kien242/Reflow-Controller/pcb/Reflow-Controller-Kicad/Reflow-Controller-Kicad.kicad_pcb

## KiCad design pcb/Reflow-Controller-Kicad/Reflow-Controller-Kicad.kicad_pcb (2023-04-20)

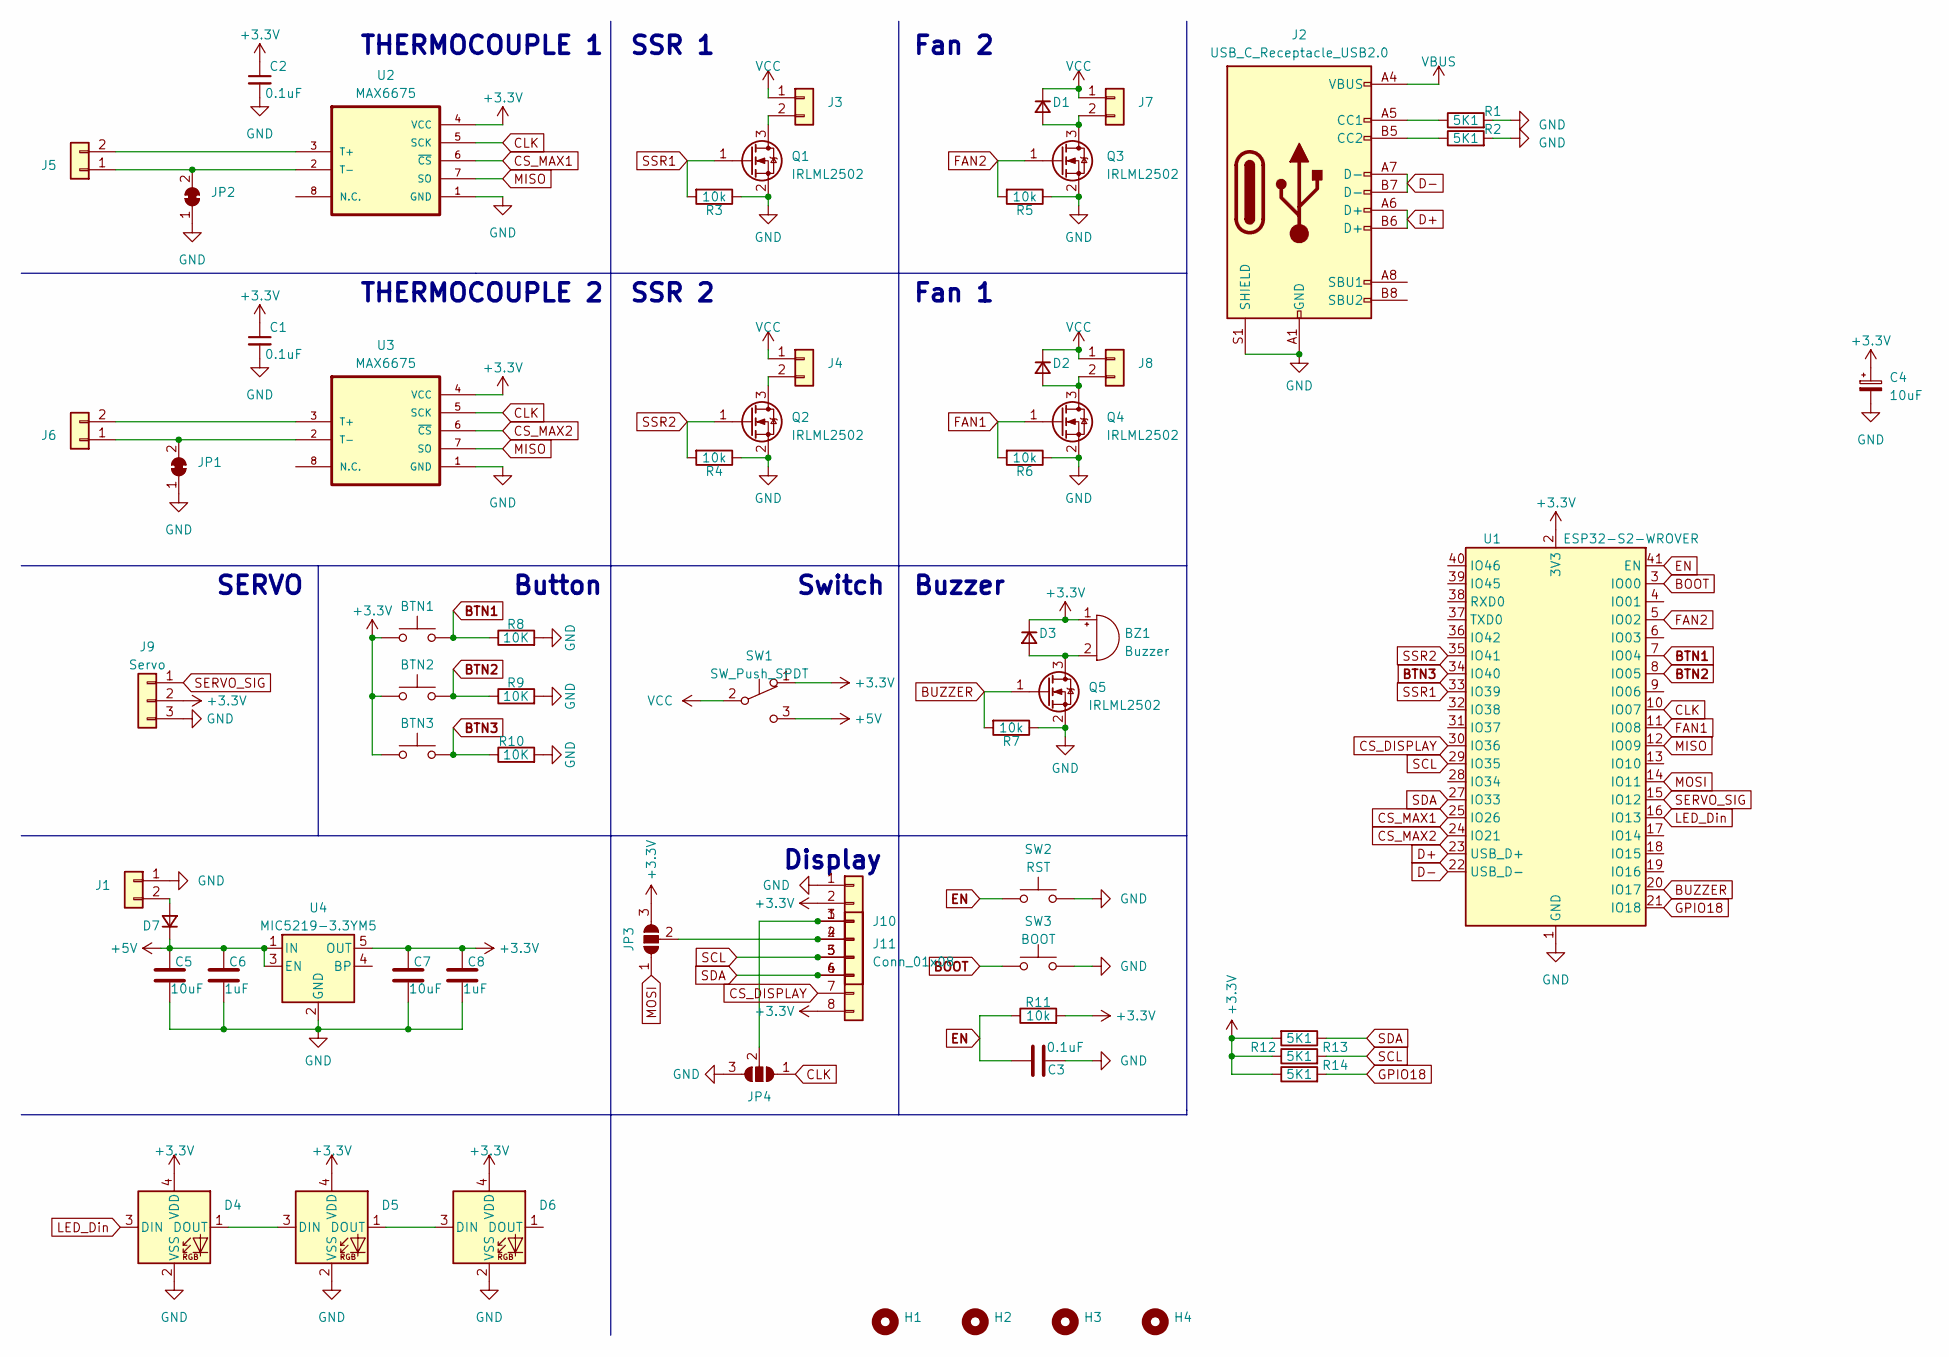
[picture p1: schematic Reflow-Controller-Kicad.kicad_sch]

Parts:
BTN1, BTN2, BTN3: SW_TL3305AF160QG
BZ1: Buzzer; MagneticBuzzer_CUI_CMT-8504-100-SMT
C1, C2, C3: 0.1uF; C_0603_1608Metric_Pad1.08x0.95mm_HandSolder
C4: 10uF; CP_EIA-3216-10_Kemet-I_Pad1.58x1.35mm_HandSolder
C5, C7: 10uF; C_0603_1608Metric_Pad1.08x0.95mm_HandSolder
C6, C8: 1uF; C_0603_1608Metric_Pad1.08x0.95mm_HandSolder
D1, D2, D3, D7: D_SOD-123
D4, D5, D6: LED_SK6812MINI_PLCC4_3.5x3.5mm_P1.75mm
H1, H2, H3, H4: MountingHole_2.7mm_M2.5_DIN965_Pad
J1, J3, J4, J5, J6, J7, J8: TerminalBlock_Phoenix_MKDS-1,5-2-5.08_1x02_P5.08mm_Horizont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
J2: USB_C_Receptacle_USB2.0; USB-C-16pin-hight-v2
J9: Servo; TerminalBlock_Phoenix_MKDS-1,5-3-5.08_1x03_P5.08mm_Horizont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
J10: 128x64OLED
J11: Conn_01x08; 0.96_TFT_Display_ST77335S
JP1, JP2: SolderJumper-2_P1.3mm_Open_TrianglePad1.0x1.5mm
JP3, JP4: SolderJumper-3_P2.0mm_Open_TrianglePad1.0x1.5mm
Q1, Q2, Q3, Q4, Q5: IRLML2502; SOT-23_Handsoldering
R1, R2, R12, R13, R14: 5K1; R_0603_1608Metric_Pad0.98x0.95mm_HandSolder
R3, R4, R5, R6, R7, R11: 10k; R_0603_1608Metric_Pad0.98x0.95mm_HandSolder
R8, R9, R10: 10K; R_0603_1608Metric_Pad0.98x0.95mm_HandSolder
SW1: SW_Push_SPDT; MSS22D18
SW2: RST; SW_SPST_B3U-1000P
SW3: BOOT; SW_SPST_B3U-1000P
U1: ESP32-S2-WROVER; MODULE_ESP32-S2-WROVER
U2, U3: MAX6675; SOIC127P600X175-8N
U4: MIC5219-3.3YM5; SOT-23-5_HandSoldering

Connections:
+3.3V: BTN1.1, BTN2.1, BTN3.1, BZ1.1 (-), C1.1, C2.1, C4.1, C7.1, C8.1, D3.1 (K), D4.4 (VDD), D5.4 (VDD), D6.4 (VDD), J9.2, J11.2, J11.8, JP3.3 (B), R11.2, R12.2, R13.1, R14.1, SW1.1 (A), U1.2 (3V3), U2.4 (VCC), U3.4 (VCC), U4.5 (OUT)
+5V: C5.1, C6.1, D7.1 (K), SW1.3 (C), U4.1 (IN), U4.3 (EN)
BOOT: SW3.1, U1.3 (IO00)
BTN1: BTN1.2, R8.1, U1.7 (IO04)
BTN2: BTN2.2, R9.1, U1.8 (IO05)
BTN3: BTN3.2, R10.1, U1.34 (IO40)
BUZZER: Q5.1 (G), R7.2, U1.20 (IO17)
CLK: JP4.1 (A), U1.10 (IO07), U2.5 (SCK), U3.5 (SCK)
CS_DISPLAY: J11.7, U1.30 (IO36)
CS_MAX1: U1.25 (IO26), U2.6 (~CS)
CS_MAX2: U1.24 (IO21), U3.6 (~CS)
D+: J2.A6 (D+), J2.B6 (D+), U1.23 (USB_D+)
D-: J2.A7 (D-), J2.B7 (D-), U1.22 (USB_D-)
EN: C3.1, R11.1, SW2.1, U1.41 (EN)
FAN1: Q4.1 (G), R6.2, U1.11 (IO08)
FAN2: Q3.1 (G), R5.2, U1.5 (IO02)
GND: C1.2, C2.2, C3.2, C4.2, C5.2, C6.2, C7.2, C8.2, D4.2 (VSS), D5.2 (VSS), D6.2 (VSS), J1.1, J2.A1 (GND), J2.A12 (GND), J2.B1 (GND), J2.B12 (GND), J2.S1 (SHIELD), J9.3, J11.1, JP1.1 (A), JP2.1 (A), JP4.3 (B), Q1.2 (S), Q2.2 (S), Q3.2 (S), Q4.2 (S), Q5.2 (S), R1.2, R2.2, R3.1, R4.1, R5.1, R6.1, R7.1, R8.2, R9.2, R10.2, SW2.2, SW3.2, U1.1 (GND), U1.26 (GND), U1.42 (GND), U1.43 (GND), U2.1 (GND), U3.1 (GND), U4.2 (GND)
GPIO18: R14.2, U1.21 (IO18)
LED_Din: D4.3 (DIN), U1.16 (IO13)
MISO: U1.12 (IO09), U2.7 (SO), U3.7 (SO)
MOSI: JP3.1 (A), U1.14 (IO11)
unnamed: BZ1.2 (+), D3.2 (A), Q5.3 (D)
unnamed: D1.2 (A), J7.2, Q3.3 (D)
unnamed: D2.2 (A), J8.2, Q4.3 (D)
unnamed: D4.1 (DOUT), D5.3 (DIN)
unnamed: D5.1 (DOUT), D6.3 (DIN)
unnamed: D7.2 (A), J1.2
unnamed: J2.A5 (CC1), R1.1
unnamed: J2.B5 (CC2), R2.1
unnamed: J3.2, Q1.3 (D)
unnamed: J4.2, Q2.3 (D)
unnamed: J5.1, JP2.2 (B), U2.2 (T-)
unnamed: J5.2, U2.3 (T+)
unnamed: J6.1, JP1.2 (B), U3.2 (T-)
unnamed: J6.2, U3.3 (T+)
unnamed: J10.1, J11.3, JP4.2 (C)
unnamed: J10.2, J11.4, JP3.2 (C)
SCL: J10.3, J11.5, R13.2, U1.29 (IO35)
SDA: J10.4, J11.6, R12.1, U1.27 (IO33)
SERVO_SIG: J9.1, U1.15 (IO12)
SSR1: Q1.1 (G), R3.2, U1.33 (IO39)
SSR2: Q2.1 (G), R4.2, U1.35 (IO41)
VBUS: J2.A4 (VBUS), J2.A9 (VBUS), J2.B4 (VBUS), J2.B9 (VBUS)
VCC: D1.1 (K), D2.1 (K), J3.1, J4.1, J7.1, J8.1, SW1.2 (B)

Notes on the sheet:
Button
THERMOCOUPLE 1
Fan 2
Display
SERVO
Fan 1
SSR 1
Switch
Buzzer
SSR 2
THERMOCOUPLE 2

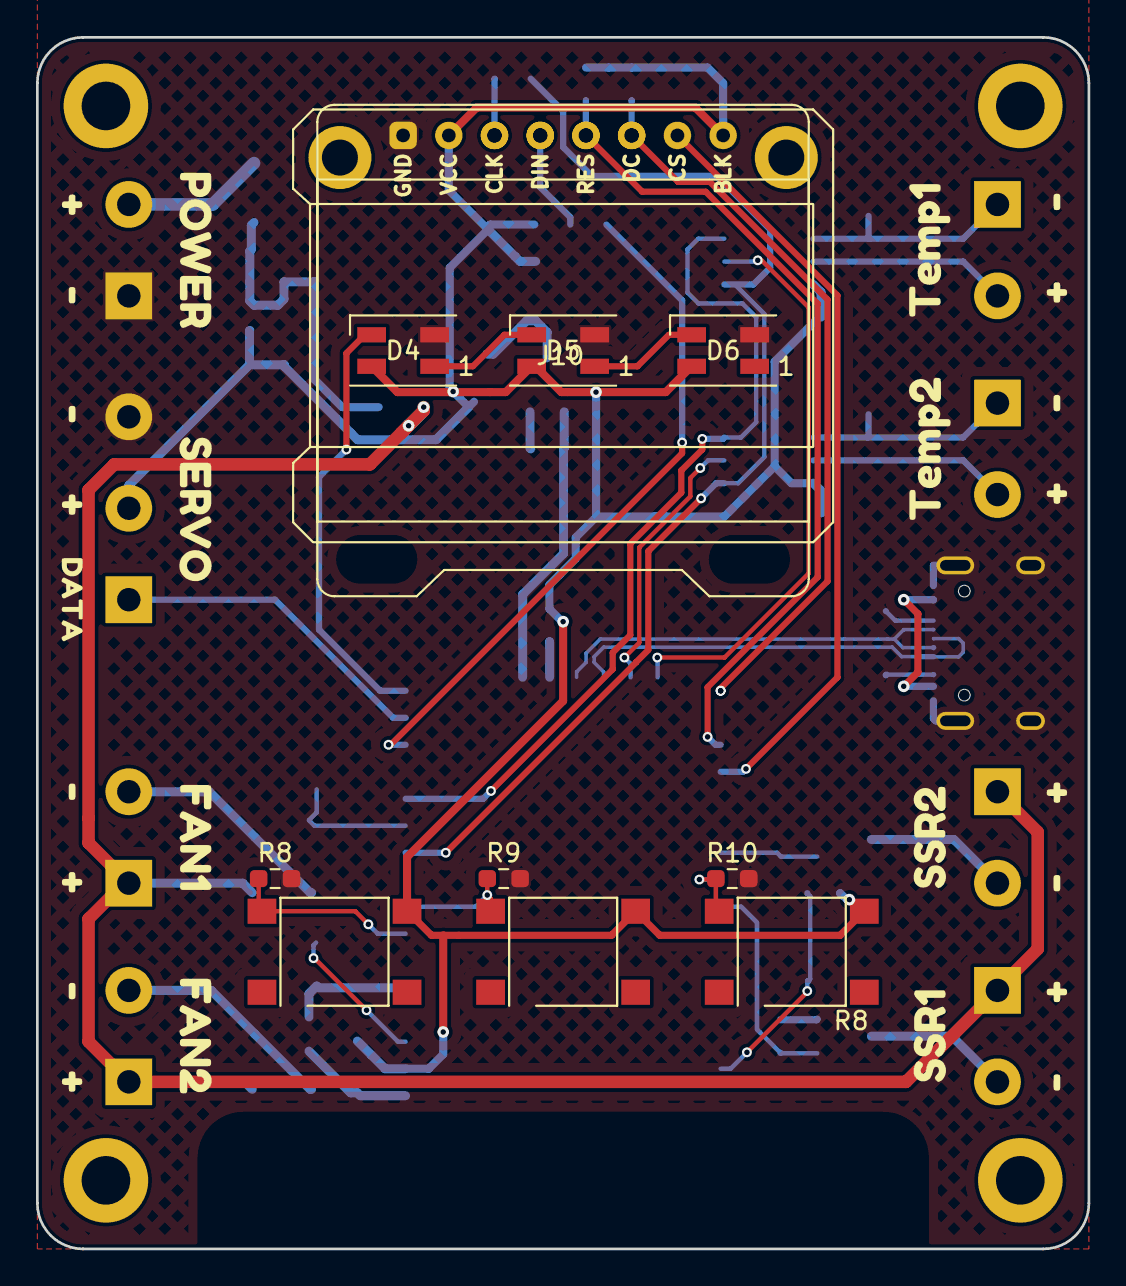
[picture p2: board Reflow-Controller-Kicad.kicad_pcb from above]

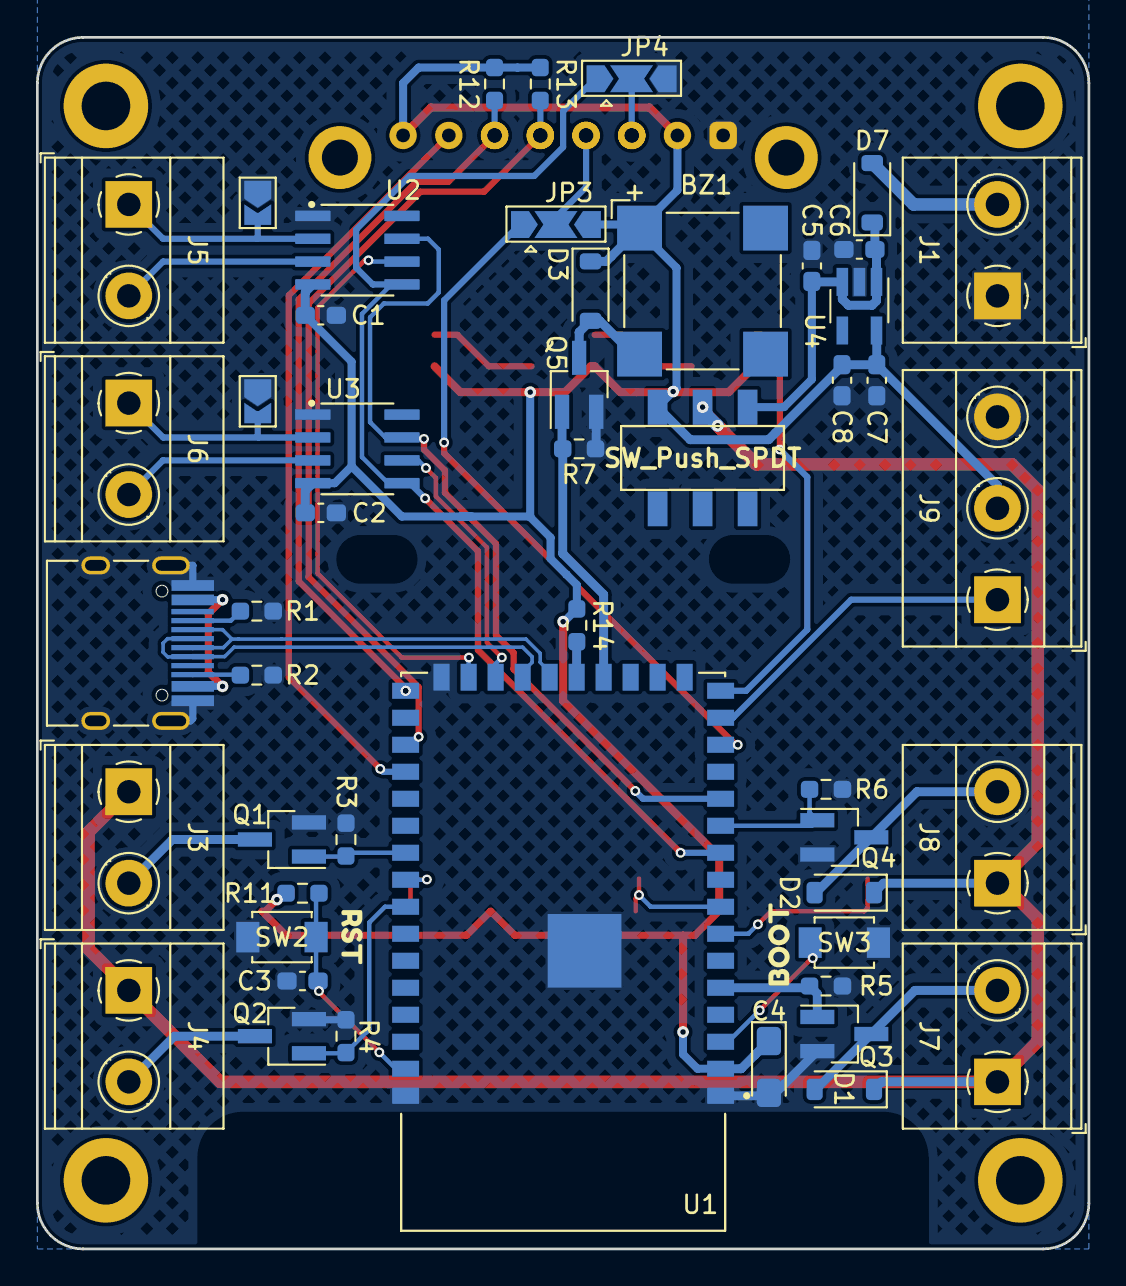
[picture p3: board Reflow-Controller-Kicad.kicad_pcb from below]

Board: 2 copper layers, 58.4 x 67.3 mm, 91 parts (51 on the bottom side), 44 nets.

Other parts of the board:
kibuzzard-643A05B4: G***; kibuzzard-643A05B4
kibuzzard-643A05BD, kibuzzard-643A05BD#2, kibuzzard-643A05BD#3, kibuzzard-643A05BD#4, kibuzzard-643A05BD#5, kibuzzard-643A05BD#6, kibuzzard-643A05BD#7, kibuzzard-643A05BD#8: G***; kibuzzard-643A05BD
kibuzzard-643A05CF, kibuzzard-643A05CF#2, kibuzzard-643A05CF#3, kibuzzard-643A05CF#4, kibuzzard-643A05CF#5, kibuzzard-643A05CF#6, kibuzzard-643A05CF#7, kibuzzard-643A05CF#8: G***; kibuzzard-643A05CF
kibuzzard-643A09AD: G***; kibuzzard-643A09AD
kibuzzard-643A051C: G***; kibuzzard-643A051C
kibuzzard-643A052F: G***; kibuzzard-643A052F
kibuzzard-643A059F: G***; kibuzzard-643A059F
kibuzzard-643A0514: G***; kibuzzard-643A0514
kibuzzard-643A0524: G***; kibuzzard-643A0524
kibuzzard-643A0580: G***; kibuzzard-643A0580
kibuzzard-643A0588: G***; kibuzzard-643A0588
kibuzzard-643A0606: G***; kibuzzard-643A0606
kibuzzard-643A0998: G***; kibuzzard-643A0998
